mekanika-dev/dck/README.md

# Dust Collection Kit

- [Assembly Guide & Documentation](https://support.mekanika.io/products/dust-collection-kit)
- [Shop](https://www.mekanika.io/en/store/be/dust-collection-kit-fab)
- [Contact](https://www.mekanika.io/contact-us/)

Dust Collection Kit

## Repository Structure

- **`bom/`** - Bill of Materials
- **`cad/`** - CAD files

The Bill of Materials is available as a CSV file, which is dynamically updated from our ERP. We recommend using this **[web viewer](https://mekanika-dev.github.io/data-sync-actions/odoo/bom-viewer.html)** to browse its content.

All 3D assembly files are made in STEP format and compatible with many CAD software. Please note that you will need Git LFS installed to clone or pull the repo correctly, since these files exceed 100MB.

The design files can also be viewed in web browsers using these links:

- [Dust Collection Kit - Evo/Pro config](https://a360.co/3VZrafZ)
- [Dust Collection Kit - Fab config](https://a360.co/4z9sc7J)

## Assembly Guide

The assembly guide is available on our [support website](https://support.mekanika.io/products/dust-collection-kit). If you have feedback or want to raise an issue about a specific assembly step, you can use the feedback buttons available on each step's page.

## Community

Mekanika encourages collaborative design and innovation. We welcome:

- Designers and engineers to contribute
- Feedback on design variations
- Any discussions around or products and potential improvements

Don't hesitate to join us on our [Discord](https://discord.gg/n7RsBtUdGc)

## License

This project is licensed under the **CERN Open Hardware Licence Version 2 - Strongly Reciprocal** ([CERN-OHL-S v2](https://ohwr.org/cern_ohl_s_v2.pdf))

For the complete license terms, see REUSE.toml
