mekanika-dev/dck/cad/DCK-Evo_Pro V2.0.stp.step

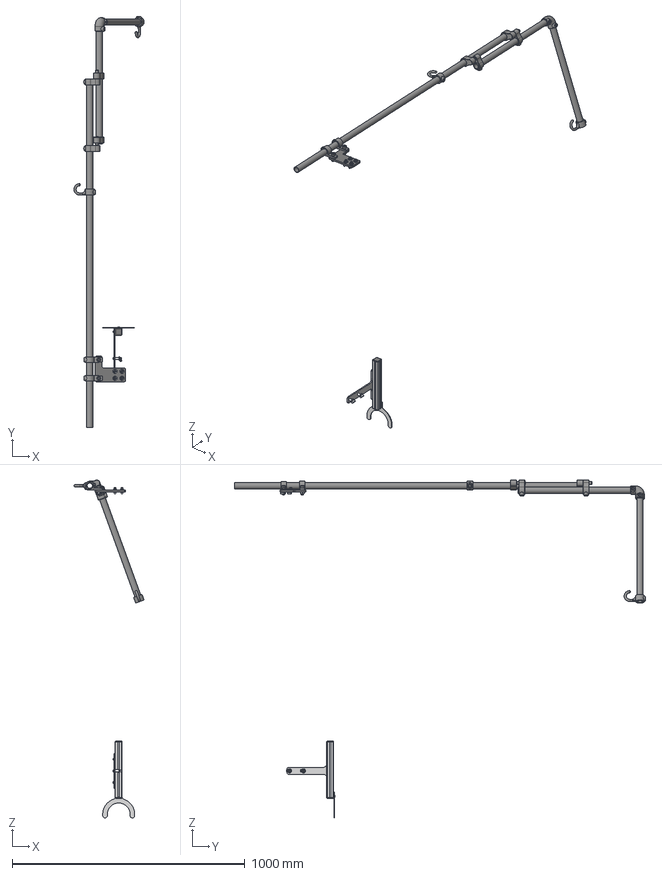
[picture p2: CAD file, 2026-09-30]
cad/DCK-Evo_Pro V2.0.stp.step
302.2 x 1769.5 x 1453.7 mm
