mekanika-dev/dck/(commit log)

2026-02-12 Initial commit with all current files
    [DCK-Fab V1.0.stp]
2026-02-12 Update of the BOM: DCK-Fab V1.0
    SKU: M01368
    File: DCK-Fab V1.0.csv
    Synced at: Thu Feb 12 13:01:16 UTC 2026
    [DCK-Fab V1.0.csv]
2026-02-12 Update of the BOM: DCK-Evo_Pro V1.0
    SKU: M01382
    File: DCK-Evo_Pro V1.0.csv
    Synced at: Thu Feb 12 13:02:57 UTC 2026
    [DCK-Evo_Pro V1.0.csv]
2026-02-18 updated readme with cad previews
2026-09-30 updated to v2.0
    [DCK-Evo_Pro V1.0.stp, DCK-Evo_Pro V2.0.stp.step, DCK-Fab V1.0.stp, DCK-Fab V2.0.step]
2026-10-05 Update of the BOM: DCK-Evo_Pro V2.0
    SKU: M01417
    File: DCK-Evo_Pro V2.0.csv
    Synced at: Mon Oct 5 10:25:25 UTC 2026
    [DCK-Evo_Pro V2.0.csv]
2026-10-05 Update of the BOM: DCK-Fab V2.0
    SKU: M01414
    File: DCK-Fab V2.0.csv
    Synced at: Mon Oct 5 12:32:40 UTC 2026
    [DCK-Fab V2.0.csv]
2026-10-05 removed v1.0 BOM files
    [DCK-Evo_Pro V1.0.csv, DCK-Fab V1.0.csv]
